trandangtrungduc/NeuralNetworkforMobileRobot/Simulation/Image/SpeedGraph.jpg

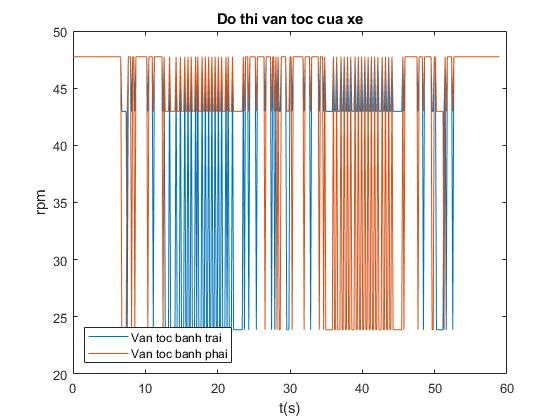
Simulation/Image/SpeedGraph.jpg
