trandangtrungduc/NeuralNetworkforMobileRobot/Docs/mobile_robot.jpg

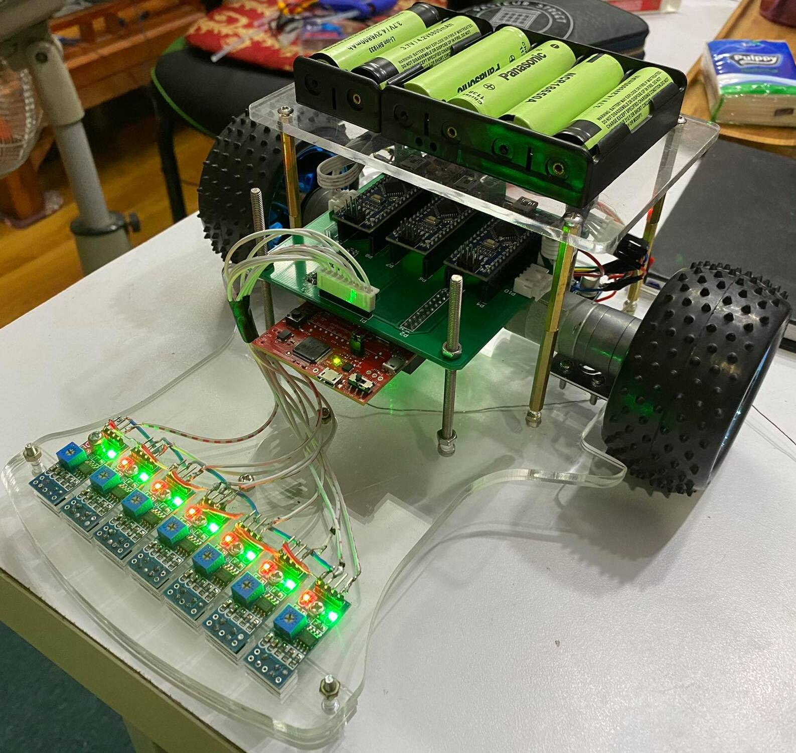
Docs/mobile_robot.jpg
