trandangtrungduc/NeuralNetworkforMobileRobot/Simulation/Image/Error_e2.jpg

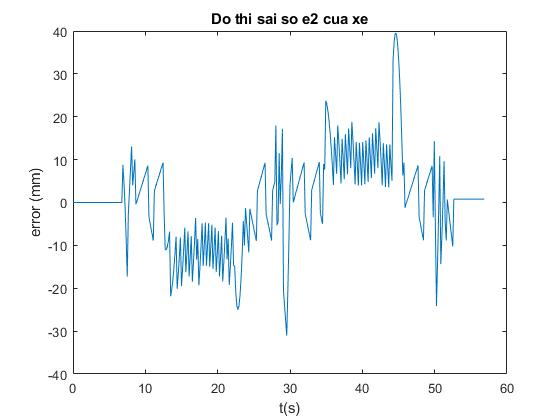
Simulation/Image/Error_e2.jpg
