trandangtrungduc/NeuralNetworkforMobileRobot/Simulation/Image/RobotSimulation.jpg

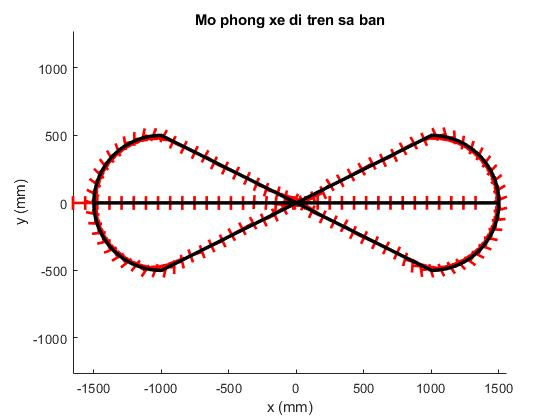
Simulation/Image/RobotSimulation.jpg
