trandangtrungduc/NeuralNetworkforMobileRobot/Simulation/Image/Trajectory.jpg

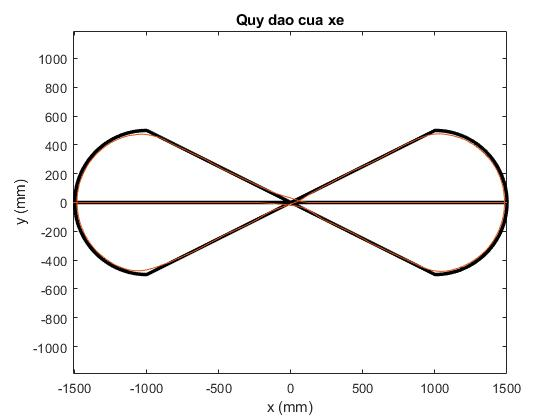
Simulation/Image/Trajectory.jpg
