trandangtrungduc/NeuralNetworkforMobileRobot/(list of files, cad)

Other CAD files:
Embedded Software/Master/Debug/GPIO/GPIO.obj
Embedded Software/Master/Debug/I2C/I2C.obj
Embedded Software/Master/Debug/TIMER/TIMER.obj
