trandangtrungduc/NeuralNetworkforMobileRobot/Drawings/AssemblyDrawing.pdf

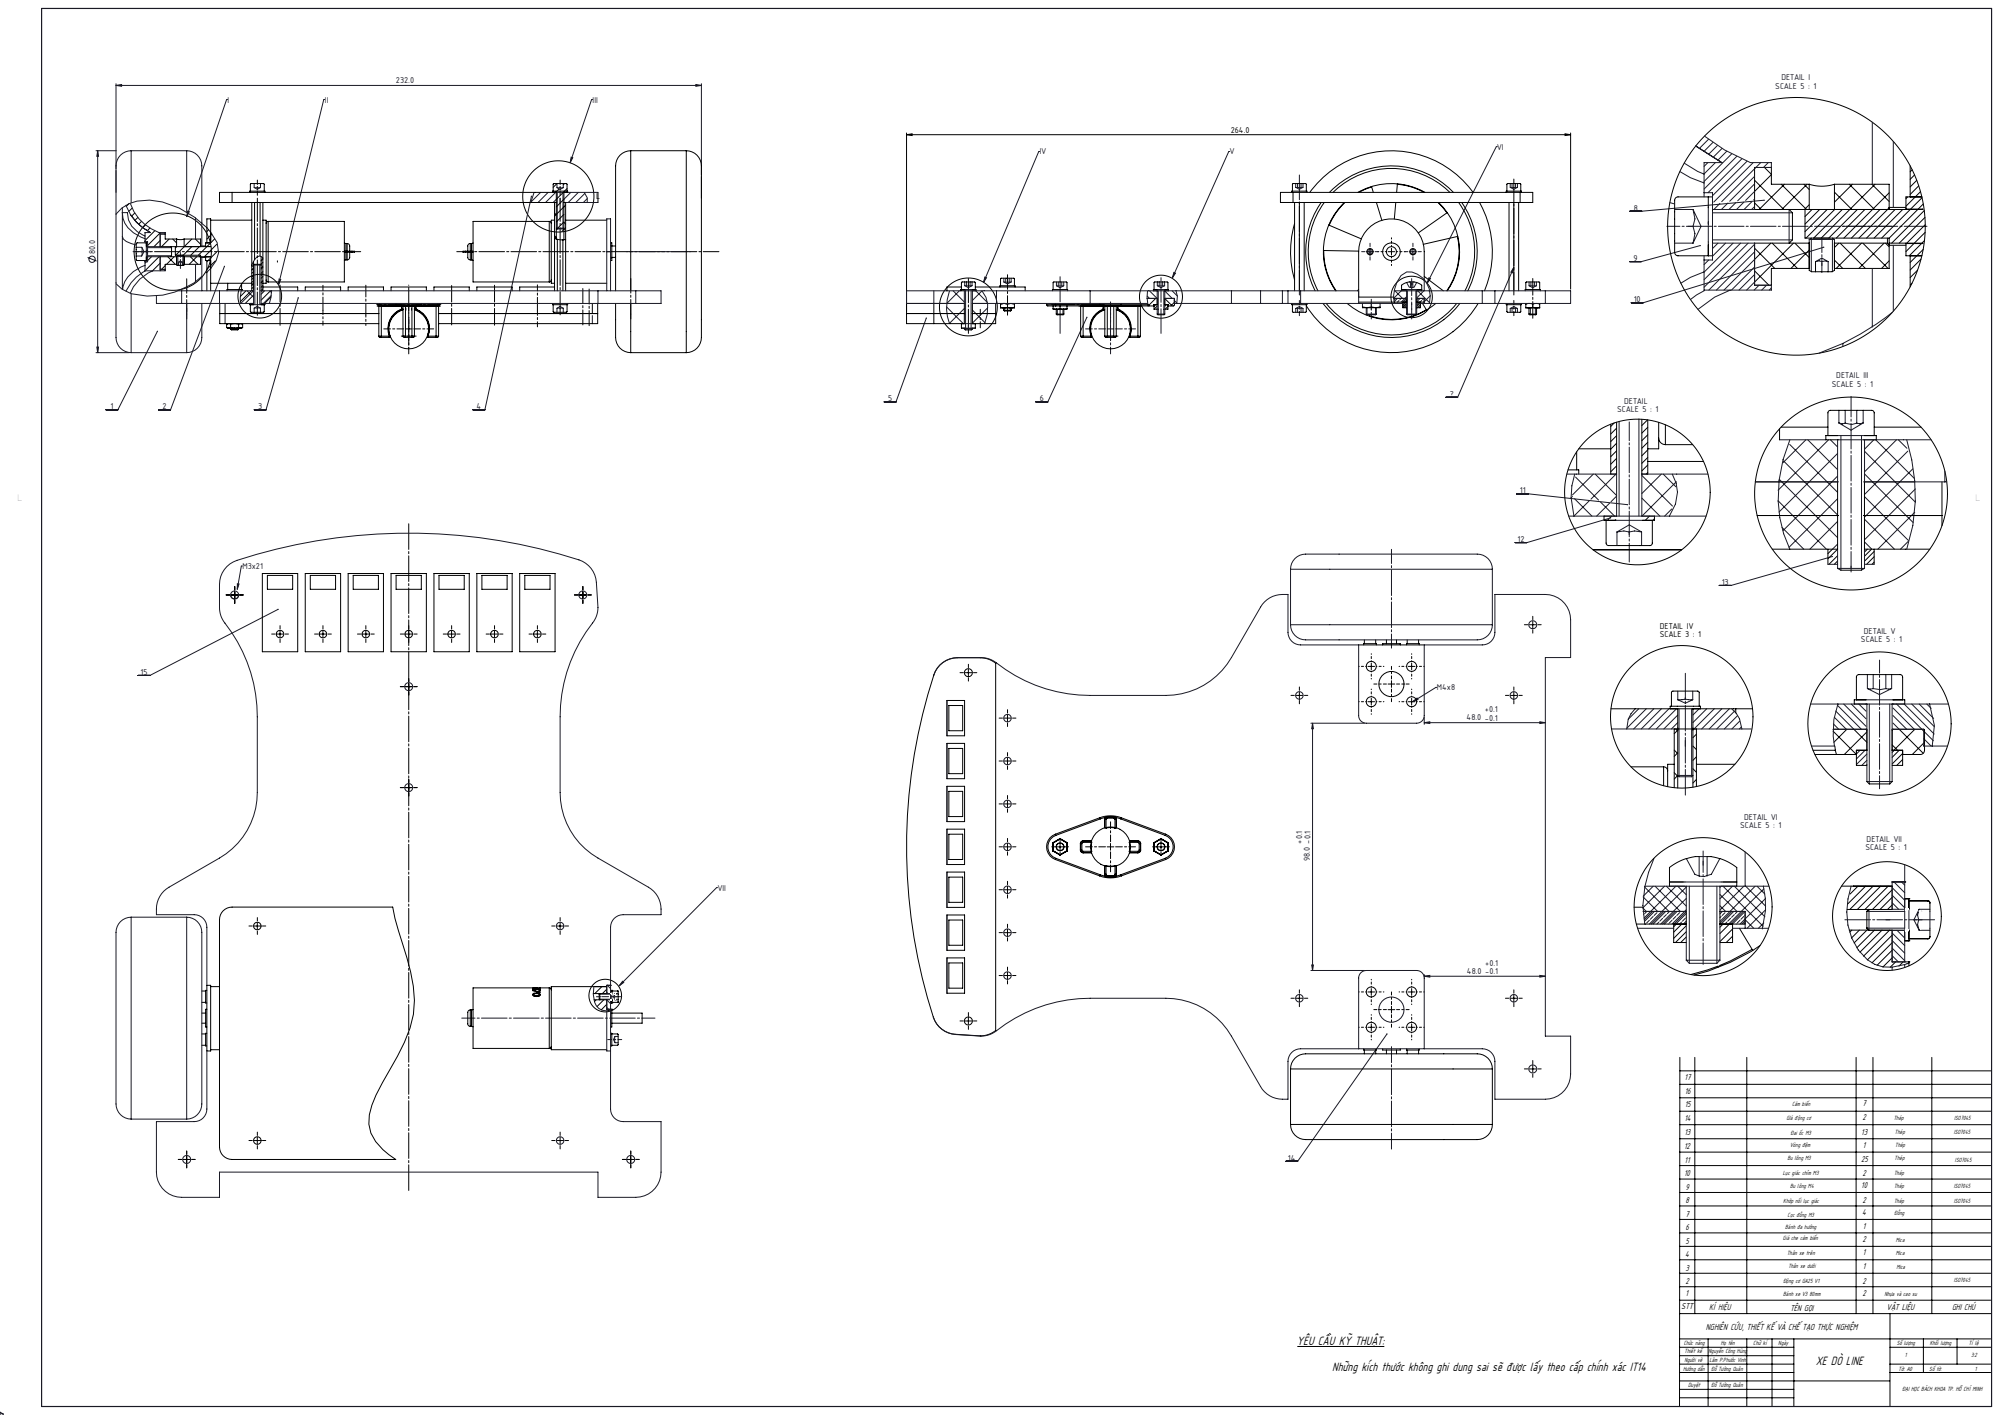
[picture p6: page 1]
DETAIL I SCALE 5 : 1; SCALE 5 : 1; DETAIL III SCALE 5 : 1; DETAIL IV SCALE 3 : 1; DETAIL VII SCALE 5 : 1; DETAIL V SCALE 5 : 1; DETAIL VI SCALE 5 : 1; Những kích thước không ghi dung sai sẽ được lấy theo cấp chính xác IT14

17
16
15 | | Cảm biến | 7
14 | | GIá động cơ | 2 | Thép | ISO7045
13 | | Đai ốc M3 | 13 | Thép | ISO7045
12 | | Vòng đệm | 1 | Thép
11 | | Bu lông M3 | 25 | Thép | ISO7045
10 | | Lục giác chìm M3 | 2 | Thép
9 | | Bu lông M4 | 10 | Thép | ISO7045
8 | | Khớp nối lục giác | 2 | Thép | ISO7045
7 | | Cọc đồng M3 | 4 | Đồng
6 | | Bánh đa hướng | 1
5 | | Giá che cảm biến | 2 | Mica
4 | | Thân xe trên | 1 | Mica
3 | | Thân xe dưới | 1 | Mica
2 | | Động cơ GA25 V1 | 2 | | ISO7045
1 | | Bánh xe V3 80mm | 2 | Nhựa và cao su
STT | KÍ HIỆU | TÊN GỌI | | VẬT LIỆU | GHI CHÚ
NGHIÊN CỨU, THIẾT KẾ VÀ CHẾ TẠO THỰC NGHIỆM
Chức năng | Họ tên | Chữ kí | Ngày | XE DÒ LINE | Số lượng | Khối lượng | Tỉ lệ
Thiết kế | Nguyễn Công Hùng | | | | 1 | | 3:2
Người vẽ | Lâm P.Phước Vinh
Hướng dẫn | Đỗ Tường Quân | | | | | Số tờ: 1

YÊU CẦU KỸ THUẬT:

Đỗ Tường Quân
Duyệt

ĐẠI HỌC BÁCH KHOA TP. HỒ CHÍ MINH
