trandangtrungduc/NeuralNetworkforMobileRobot/Drawings/AlgorithmDrawing.pdf

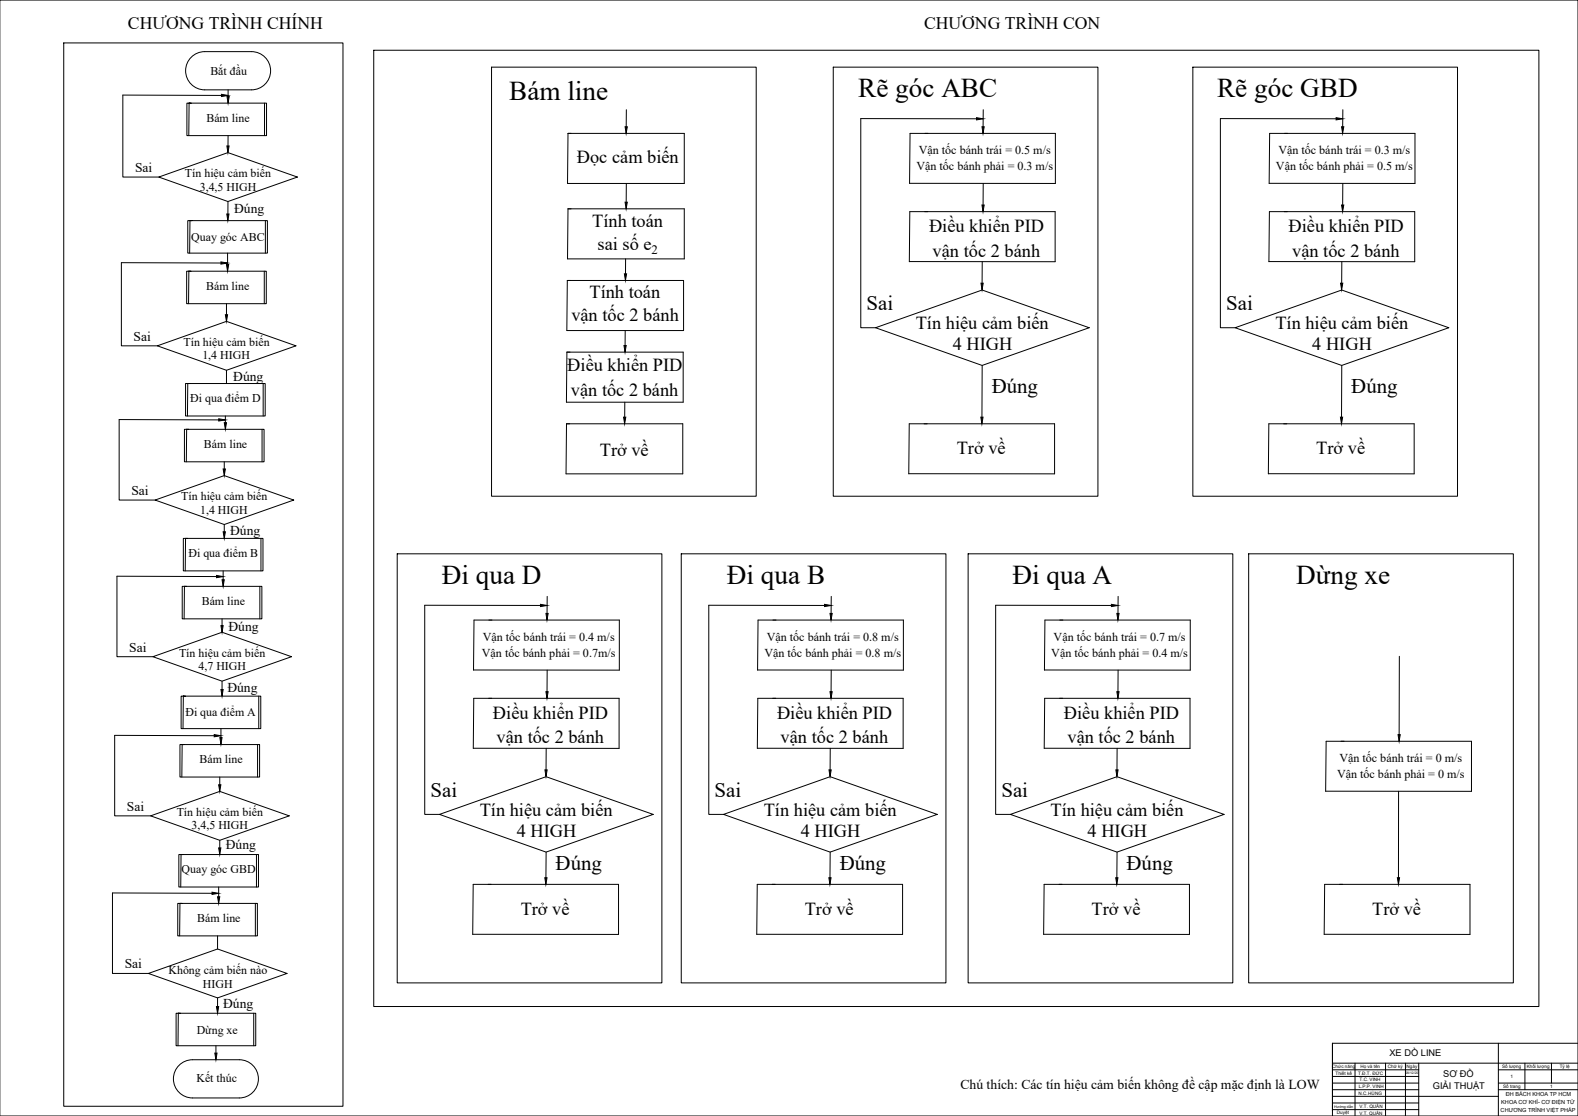
[picture p7: page 1]
Bắt đầu CHƯƠNG TRÌNH CHÍNH; Thiết kế; 1 Chức năng; Họ và tên; Chữ ký; Ngày; Khối lượng; Tỷ lệ XE DÒ LINE; ĐH BÁCH KHOA TP HCM KHOA CƠ KHÍ- CƠ ĐIỆN TỬ CHƯƠNG TRÌNH VIỆT PHÁP SƠ ĐỒ GIẢI THUẬT Tín hiệu cảm biến 3,4,5 HIGH; CHƯƠNG TRÌNH CON; Duyệt Hướng dẫn; V.T. QUÂN L.P.P. VINH N.C.HÙNG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
