trandangtrungduc/NeuralNetworkforMobileRobot/Drawings/ElectricDrawing.pdf

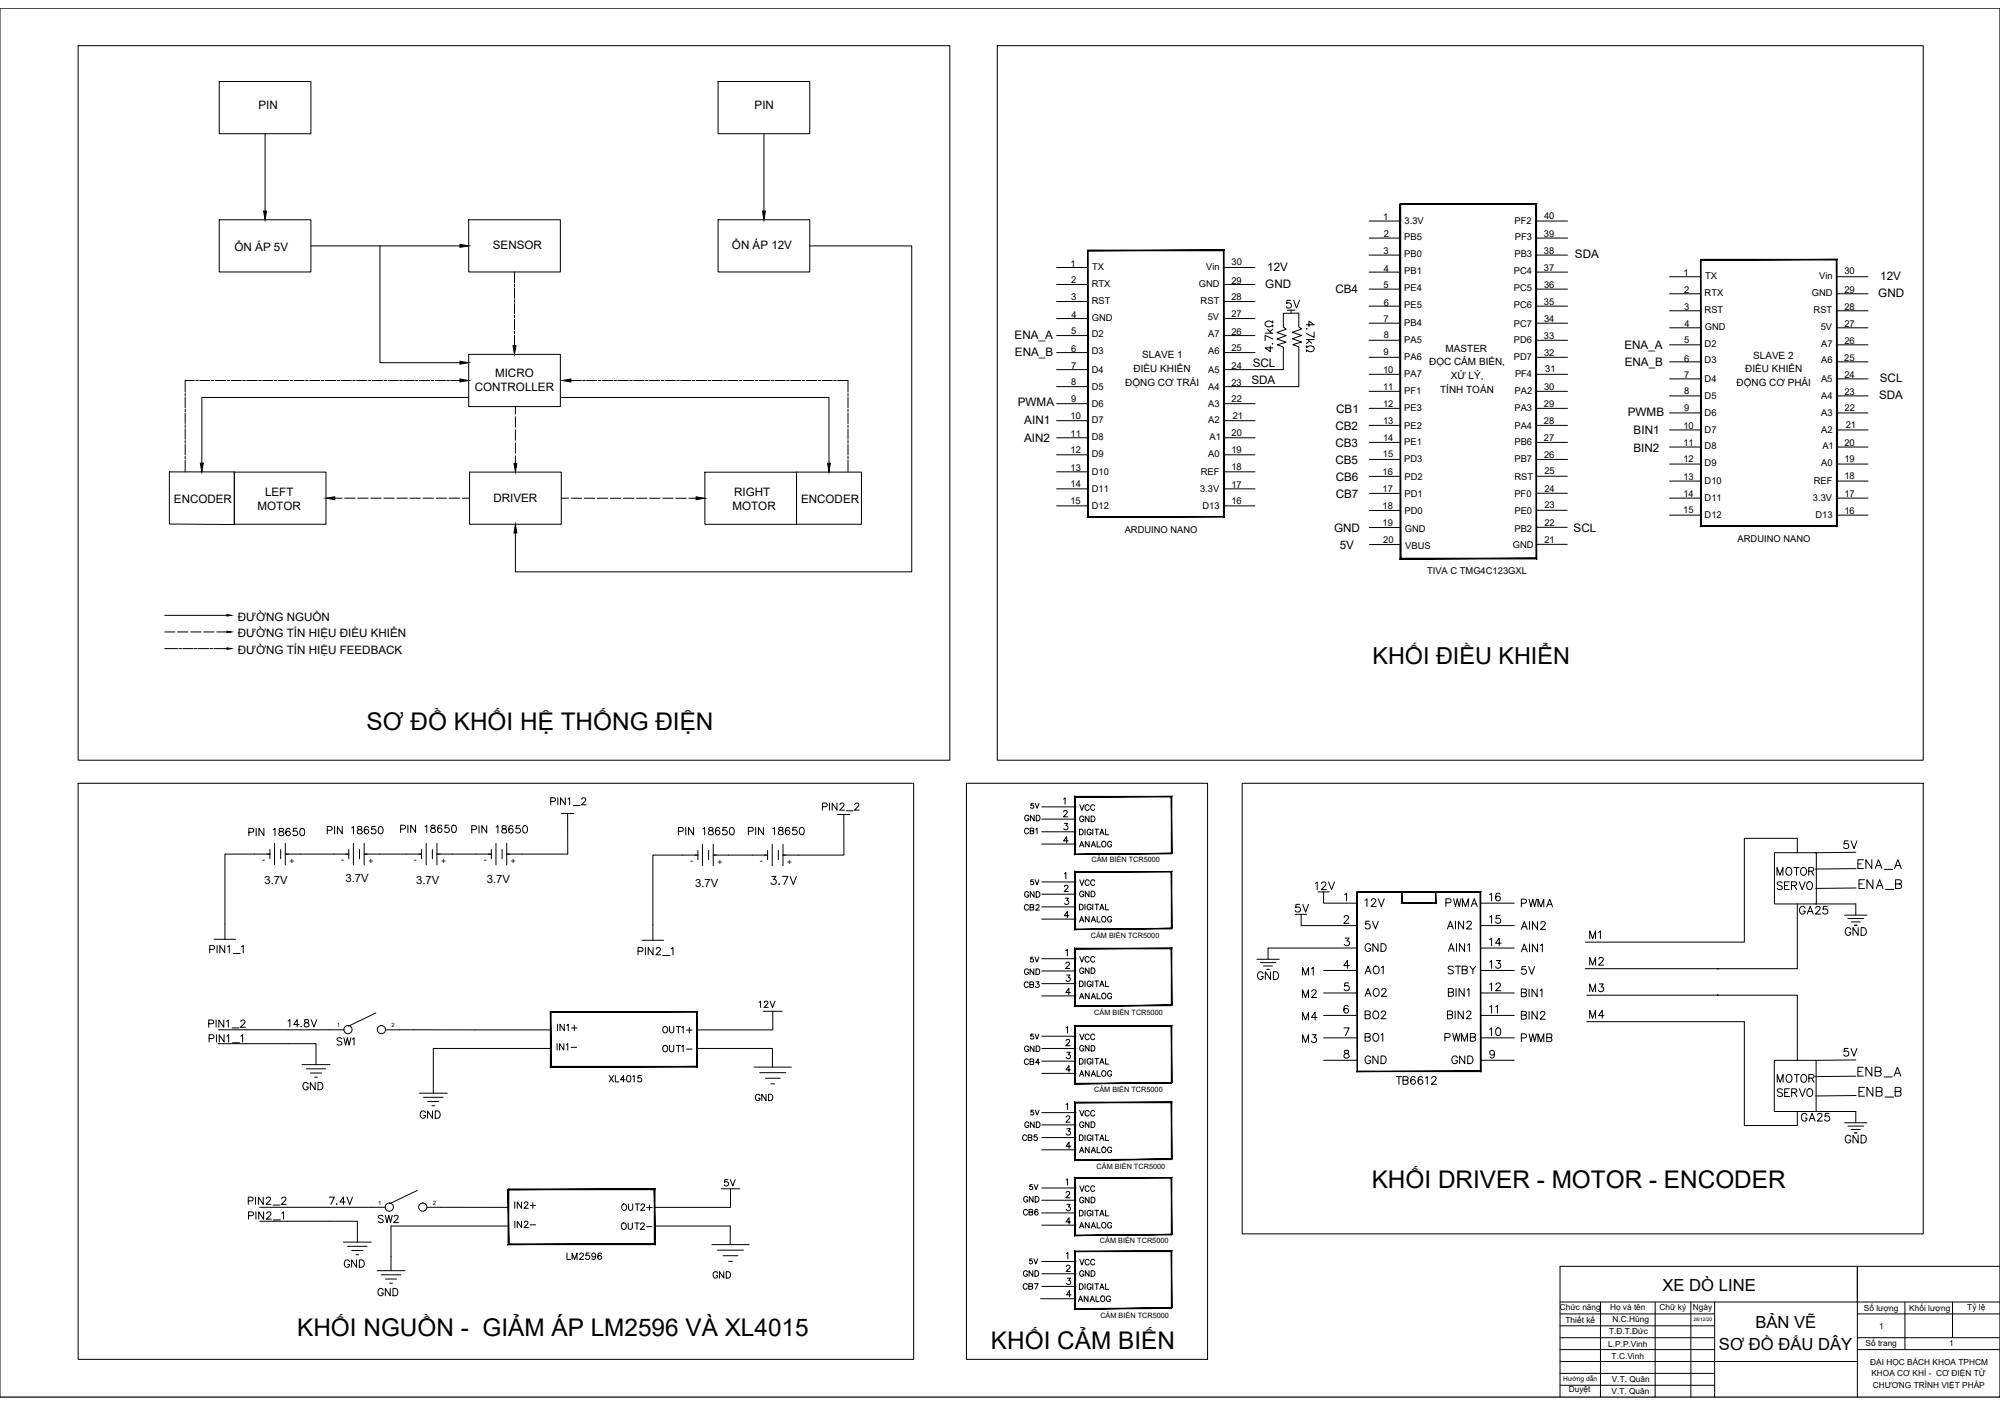
[picture p8: page 1]

ĐƯỜNG NGUỒN
ĐƯỜNG TÍN HIỆU ĐIỀU KHIỂN

SƠ ĐỒ KHỐI HỆ THỐNG ĐIỆN

BẢN VẼ
SƠ ĐỒ ĐẤU DÂY
