trandangtrungduc/NeuralNetworkforMobileRobot/(commit log)

2021-02-23 fist commit
    [input.xlsx, output.xlsx, output2.xlsx]
2021-10-04 restructure folders
    [GPIO.obj, I2C.obj, TIMER.obj, input.xlsx, output.xlsx, output2.xlsx]
